6static/m25-remote/enclosure/out/assembly_btn3_top.step

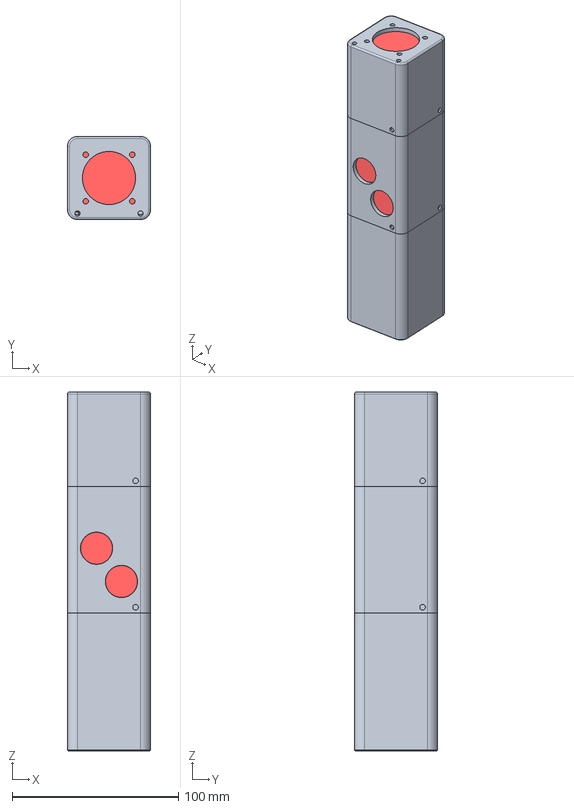
[picture p1: CAD file, 2026-11-11]
enclosure/out/assembly_btn3_top.step
50.0 x 50.0 x 216.0 mm
module_bottom
module_btn3_top
module_btn3_top_button0
module_btn3_top_button1
module_btn3_top_button2
module_top_smc30
smc30_envelope
esp32_envelope
