6static/m25-remote/enclosure/out/assembly_diag.step

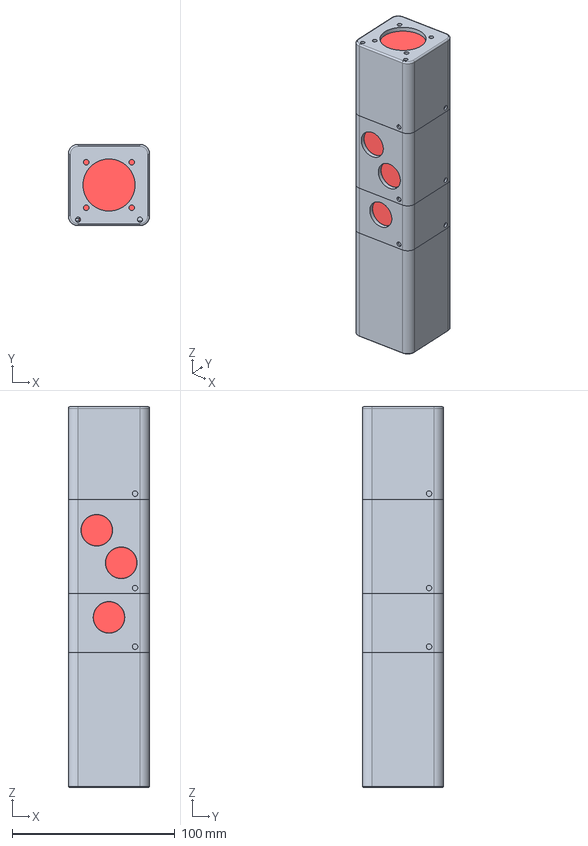
[picture p2: CAD file, 2026-11-11]
enclosure/out/assembly_diag.step
50.0 x 50.0 x 234.0 mm
module_bottom
module_btn1
module_btn1_button0
module_btn2_diag
module_btn2_diag_button0
module_btn2_diag_button1
module_top_smc30
smc30_envelope
esp32_envelope
