6static/m25-remote/enclosure/out/assembly_top_btn.step

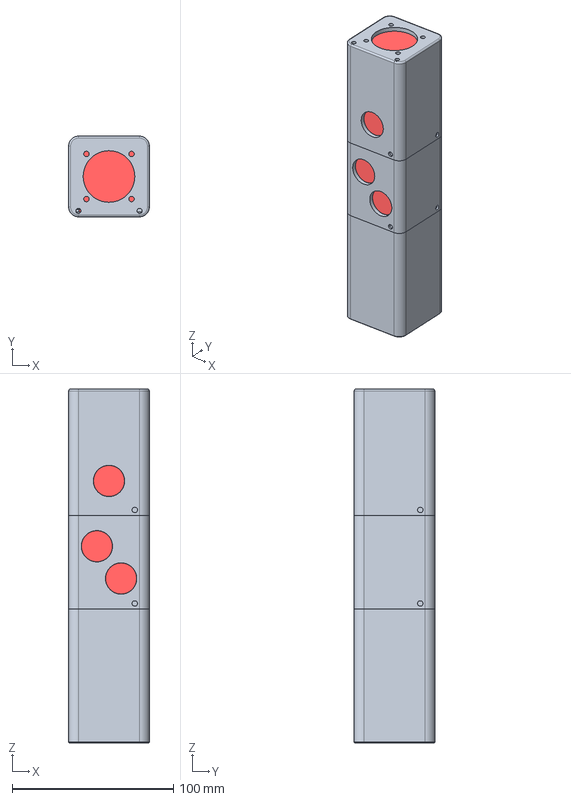
[picture p3: CAD file, 2026-11-11]
enclosure/out/assembly_top_btn.step
50.0 x 50.0 x 219.5 mm
module_bottom
module_btn2_diag
module_btn2_diag_button0
module_btn2_diag_button1
module_top_smc30_btn
module_top_smc30_btn_button0
smc30_envelope
esp32_envelope
