6static/m25-remote/enclosure/out/assembly_btn3.step

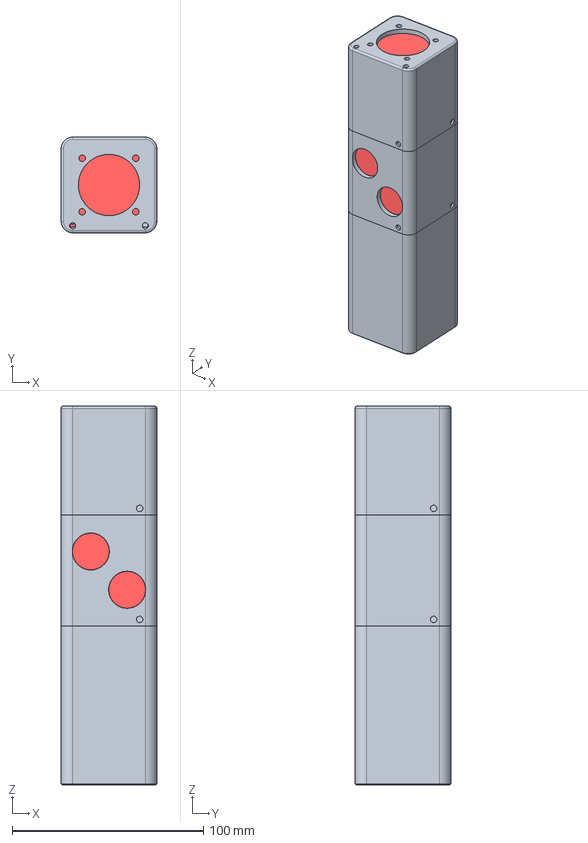
[picture p4: CAD file, 2026-11-11]
enclosure/out/assembly_btn3.step
50.0 x 50.0 x 198.0 mm
module_bottom
module_btn3
module_btn3_button0
module_btn3_button1
module_btn3_button2
module_top_smc30
smc30_envelope
esp32_envelope
