6static/m25-remote/enclosure/out/assembly_ky023.step

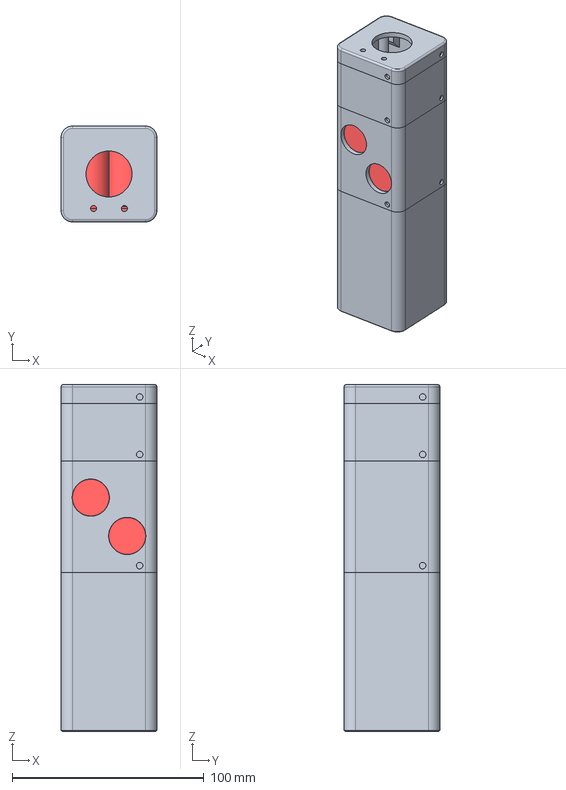
[picture p5: CAD file, 2026-11-11]
enclosure/out/assembly_ky023.step
50.0 x 50.0 x 181.0 mm
module_bottom
module_btn3
module_btn3_button0
module_btn3_button1
module_btn3_button2
module_top
lid_ky023
esp32_envelope
