6static/m25-remote/enclosure/out/module_btn1.step

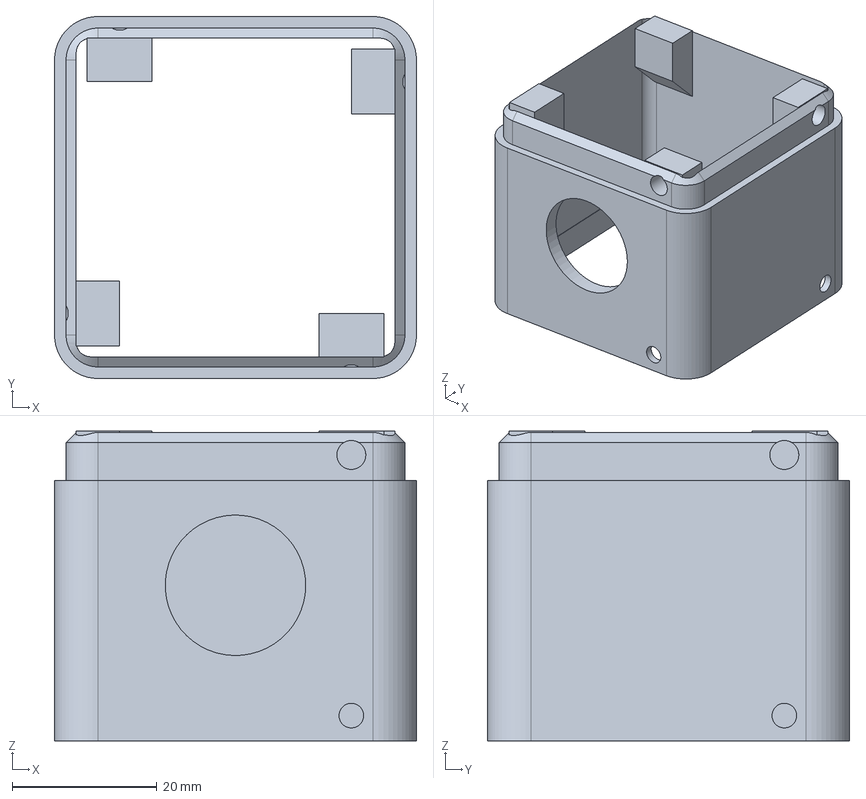
[picture p6: CAD file, 2026-11-11]
enclosure/out/module_btn1.step
50.0 x 50.0 x 42.8 mm
