6static/m25-remote/enclosure/out/module_btn3.step

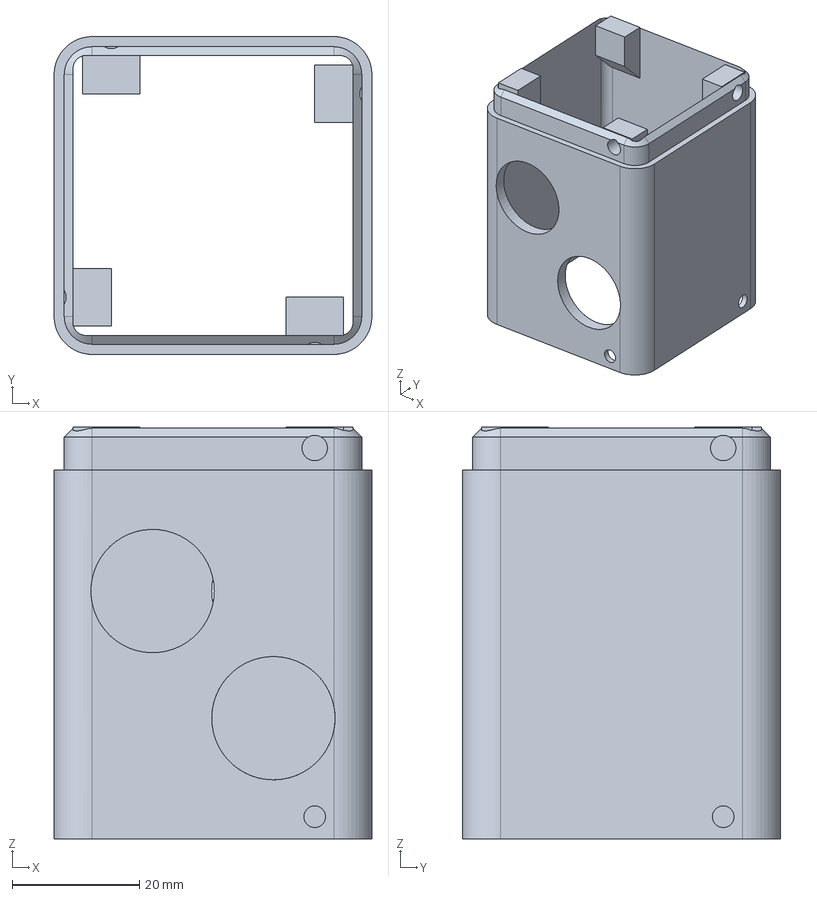
[picture p7: CAD file, 2026-11-11]
enclosure/out/module_btn3.step
50.0 x 50.0 x 64.8 mm
