6static/m25-remote/enclosure/out/module_btn2.step

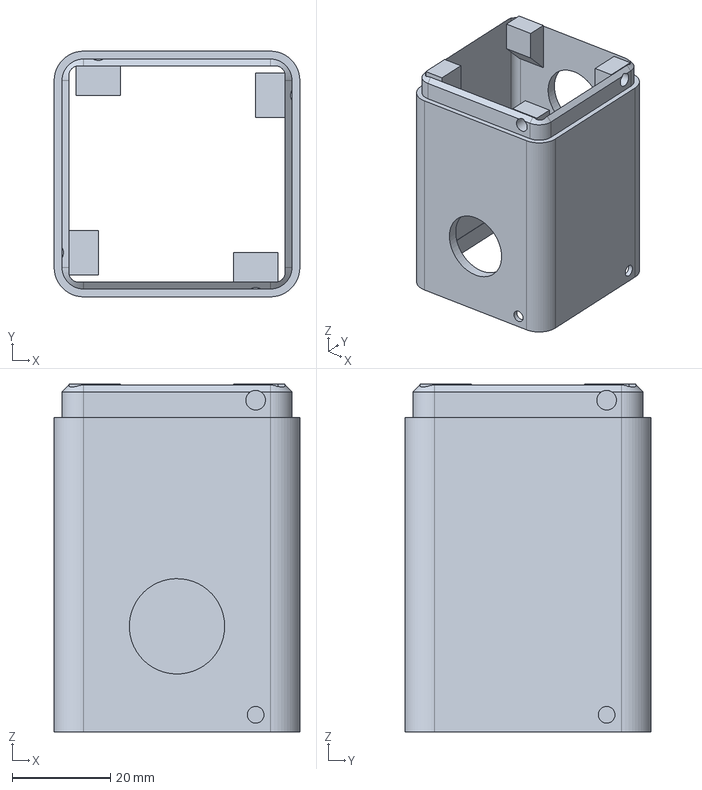
[picture p8: CAD file, 2026-11-11]
enclosure/out/module_btn2.step
50.0 x 50.0 x 70.8 mm
