6static/m25-remote/enclosure/out/module_top_smc30_btn.step

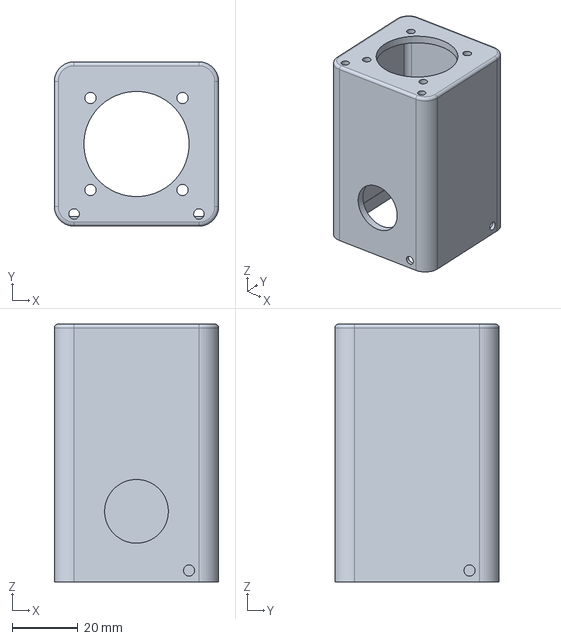
[picture p9: CAD file, 2026-11-11]
enclosure/out/module_top_smc30_btn.step
50.0 x 50.0 x 78.5 mm
