6static/m25-remote/enclosure/out/module_bottom.step

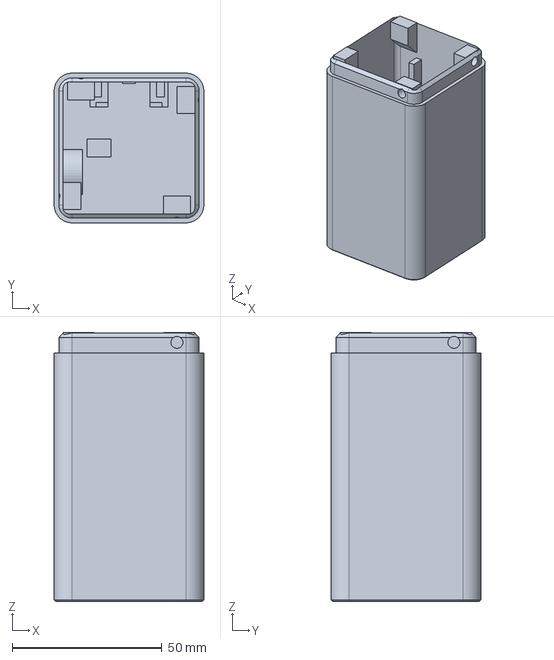
[picture p10: CAD file, 2026-11-11]
enclosure/out/module_bottom.step
50.0 x 50.0 x 89.8 mm
