6static/m25-remote/enclosure/out/lid_ky023.step

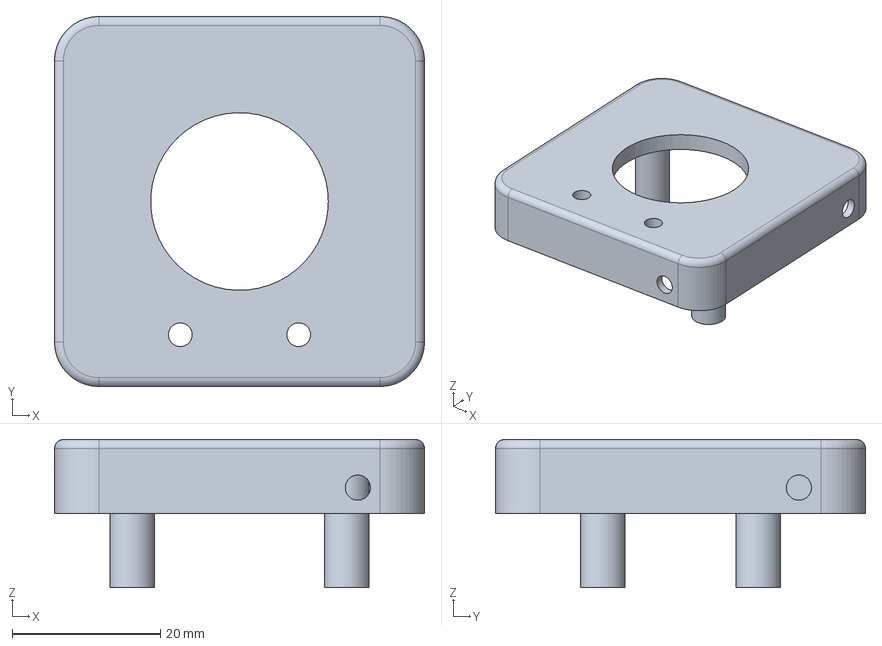
[picture p11: CAD file, 2026-11-11]
enclosure/out/lid_ky023.step
50.0 x 50.0 x 20.0 mm
