6static/m25-remote/enclosure/out/module_top_smc30.step

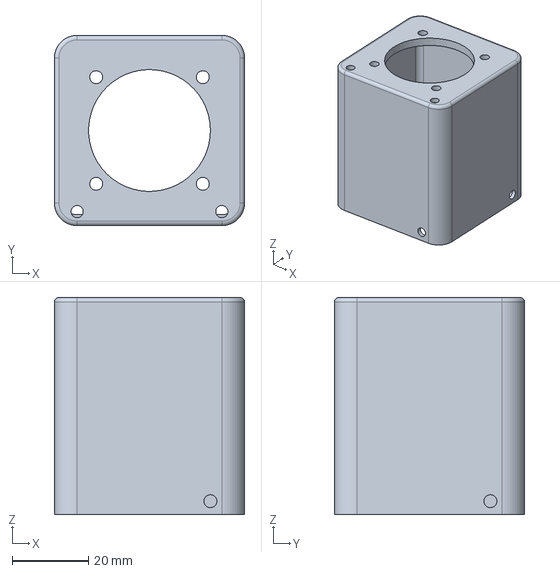
[picture p12: CAD file, 2026-11-11]
enclosure/out/module_top_smc30.step
50.0 x 50.0 x 57.0 mm
