6static/m25-remote/enclosure/out/module_top.step

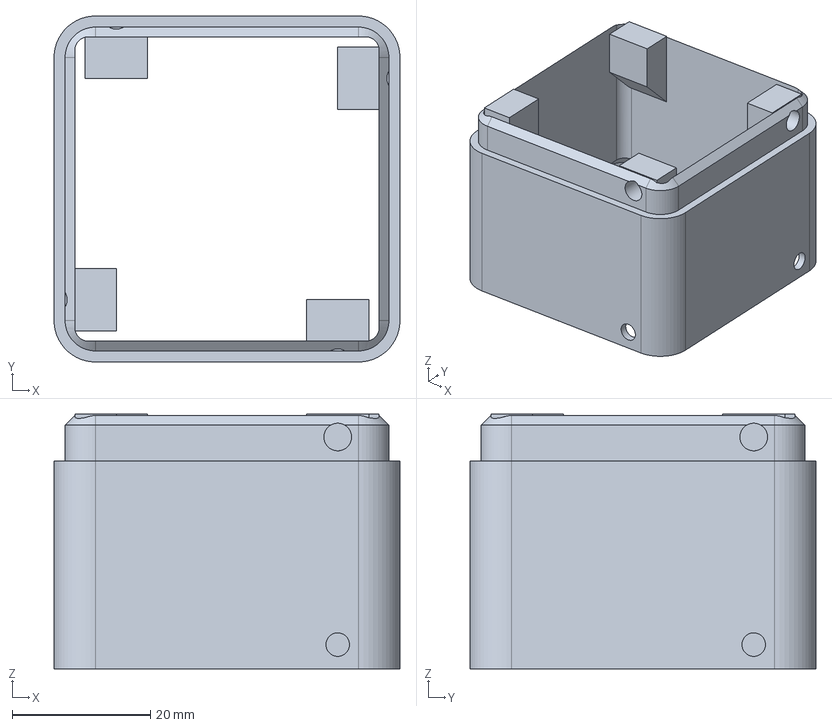
[picture p13: CAD file, 2026-11-11]
enclosure/out/module_top.step
50.0 x 50.0 x 36.8 mm
