6static/m25-remote/enclosure/out/module_btn3_top.step

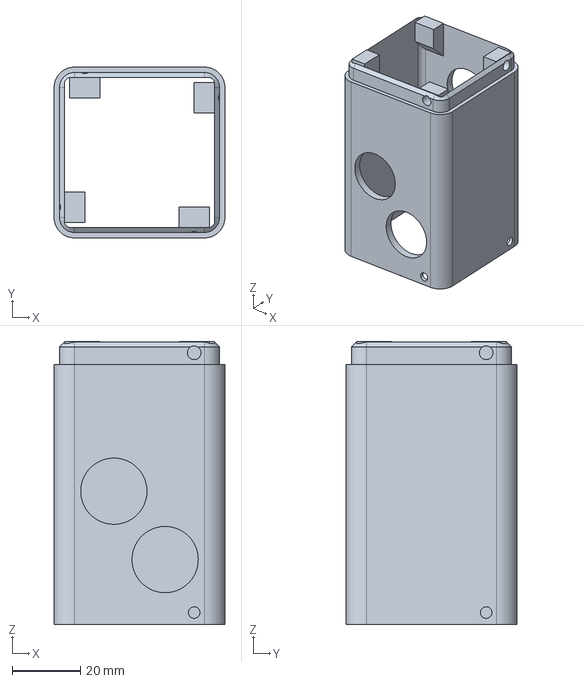
[picture p14: CAD file, 2026-11-11]
enclosure/out/module_btn3_top.step
50.0 x 50.0 x 82.8 mm
