6static/m25-remote/(list of files, cad)

Other CAD files:
enclosure/out/assembly_example.step
enclosure/out/assembly_diag_rev.step
enclosure/out/module_btn2_diag.step
enclosure/out/module_btn2_diag_rev.step
enclosure/out/lid_ky023.stl
enclosure/out/module_bottom.stl
enclosure/out/module_btn1.stl
enclosure/out/module_btn2.stl
enclosure/out/module_btn2_diag.stl
enclosure/out/module_btn2_diag_rev.stl
enclosure/out/module_btn3.stl
enclosure/out/module_btn3_top.stl
enclosure/out/module_top.stl
enclosure/out/module_top_smc30.stl
enclosure/out/module_top_smc30_btn.stl
