6static/m25-remote/(commit log)

2026-11-10 feat(enclosure): add modular printable remote case
    Stackable 50 x 50 mm modules (1, 2 and 3 buttons, SMC30B joystick top, ESP32 bottom) let us try different button layouts on the X1C without redesigning; a parametric CadQuery script regenerates STEP for Fusion and print-oriented STL, and checks the stack for collisions.
    [assembly_btn3.step, assembly_example.step, assembly_ky023.step, lid_ky023.step, lid_ky023.stl, module_bottom.step, module_bottom.stl, module_btn1.step]
2026-11-11 fix(enclosure): move SMC30B LEDs to the front corners
    The rubber boot hid the LEDs at 22.7 mm from the stick axis; the corners put them at 28.6 mm, the farthest the flange underneath allows.
    [assembly_btn3.step, assembly_example.step, assembly_ky023.step, lid_ky023.step, module_bottom.step, module_btn1.step, module_btn2.step, module_btn3.step]
2026-11-11 feat(enclosure): add diagonal button module variants
    Adds a 3-button module with the back button centred above a narrower front diagonal, and 2-button front-diagonal modules in both directions, so layouts can be compared by printing.
    [assembly_btn3.step, assembly_btn3_top.step, assembly_diag.step, assembly_diag_rev.step, assembly_example.step, assembly_ky023.step, lid_ky023.step, module_bottom.step]
2026-11-11 feat(enclosure): add joystick top with one button
    The SMC30B body fills the interior, so the button sits below it; the top grows by 21.5 mm but saves the separate 1-button module.
    [assembly_btn3.step, assembly_btn3_top.step, assembly_diag.step, assembly_diag_rev.step, assembly_example.step, assembly_ky023.step, assembly_top_btn.step, lid_ky023.step]
2026-11-11 feat(site): add enclosure preview site with Pages deploy
    A standalone page for showing off the printed parts: drawings print bed-up as each part comes into view and every part or stack can be turned in 3D from its STL. Assets are built on demand from enclosure/out by build.py (optionally regenerating the enclosure first), and a Pages workflow runs the same build in CI.
